blemasle/gpstracker-pcb/gpstracker-interface.sch

## KiCad design gpstracker-interface.sch (2019-01-05)

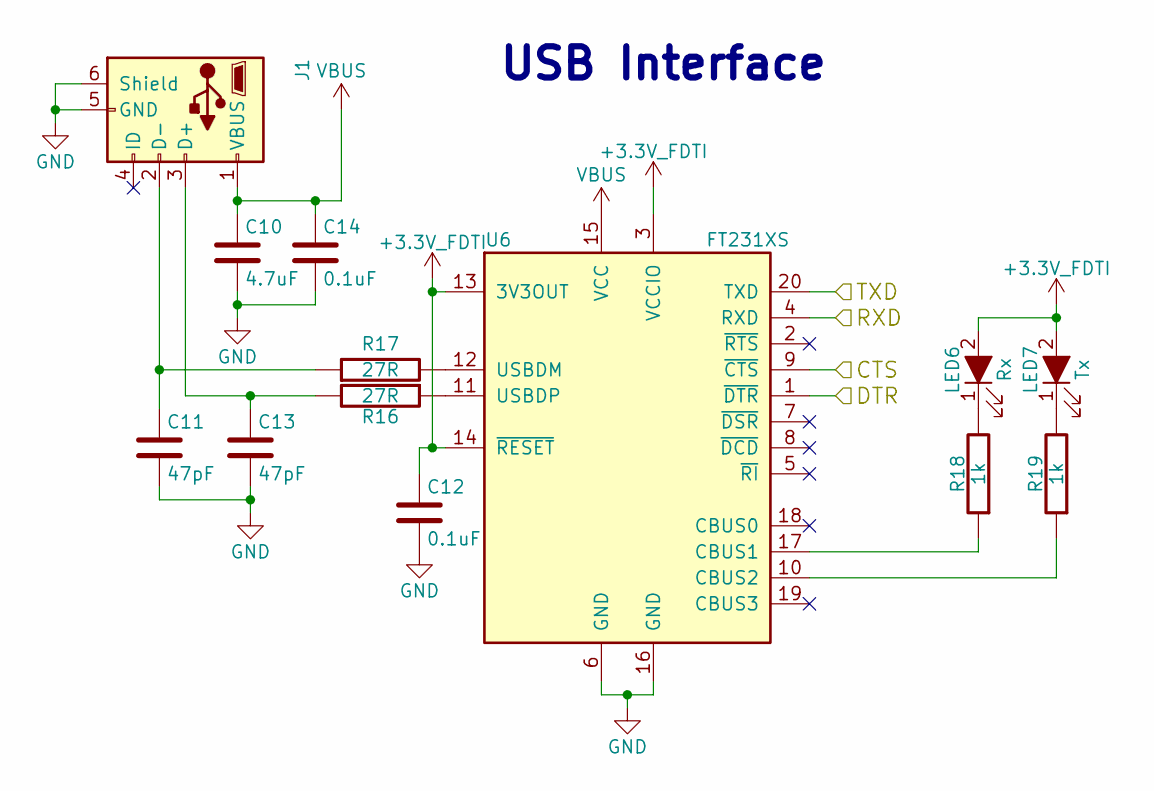
[picture p1: schematic gpstracker-interface.sch]

Parts:
C10: 4.7uF; C_0805_HandSoldering; Manufacturer part number C0805C104M3RACTU
C11, C13: 47pF; C_0805_HandSoldering; Manufacturer part number VJ0805A470GXJPW1BC
C12, C14: 0.1uF; C_0805_HandSoldering; Manufacturer part number C0805C104M3RACTU
J1: Molex 105133-0002; USB_Micro-B_Wuerth-614105150721_Vertical_CircularHoles; Manufacturer part number 614105150721
LED6: Rx; LED_0805_HandSoldering; Manufacturer part number APT2012SYCK
LED7: Tx; LED_0805_HandSoldering; Manufacturer part number APT2012EC
R16, R17: 27R; R_0805_HandSoldering; Manufacturer part number ERJ-6GEYJ270V
R18, R19: 1k; R_0805_HandSoldering; Manufacturer part number ERJ-6GEYJ102V
U6: FT231XS; SSOP-20_4.4x6.5mm_Pitch0.65mm; Manufacturer part number FT231XS-U

Connections:
+3.3V_FDTI: C12.1, LED6.2 (A), LED7.2 (A), U6.3 (VCCIO), U6.13 (3V3OUT), U6.14 (~RESET)
CTS: U6.9 (~CTS)
DTR: U6.1 (~DTR)
GND: C10.2, C11.2, C12.2, C13.2, C14.2, J1.5 (GND), J1.6 (Shield), U6.6 (GND), U6.16 (GND)
unnamed: C11.1, J1.2 (D-), R17.1
unnamed: C13.1, J1.3 (D+), R16.2
unnamed: LED6.1 (K), R18.2
unnamed: LED7.1 (K), R19.2
unnamed: R16.1, U6.11 (USBDP)
unnamed: R17.2, U6.12 (USBDM)
unnamed: R18.1, U6.17 (CBUS1)
unnamed: R19.1, U6.10 (CBUS2)
RXD: U6.4 (RXD)
TXD: U6.20 (TXD)
VBUS: C10.1, C14.1, J1.1 (VBUS), U6.15 (VCC)

Notes on the sheet:
USB Interface
