blemasle/gpstracker-pcb/gpstracker.sch

## KiCad design gpstracker.sch (2019-01-05)

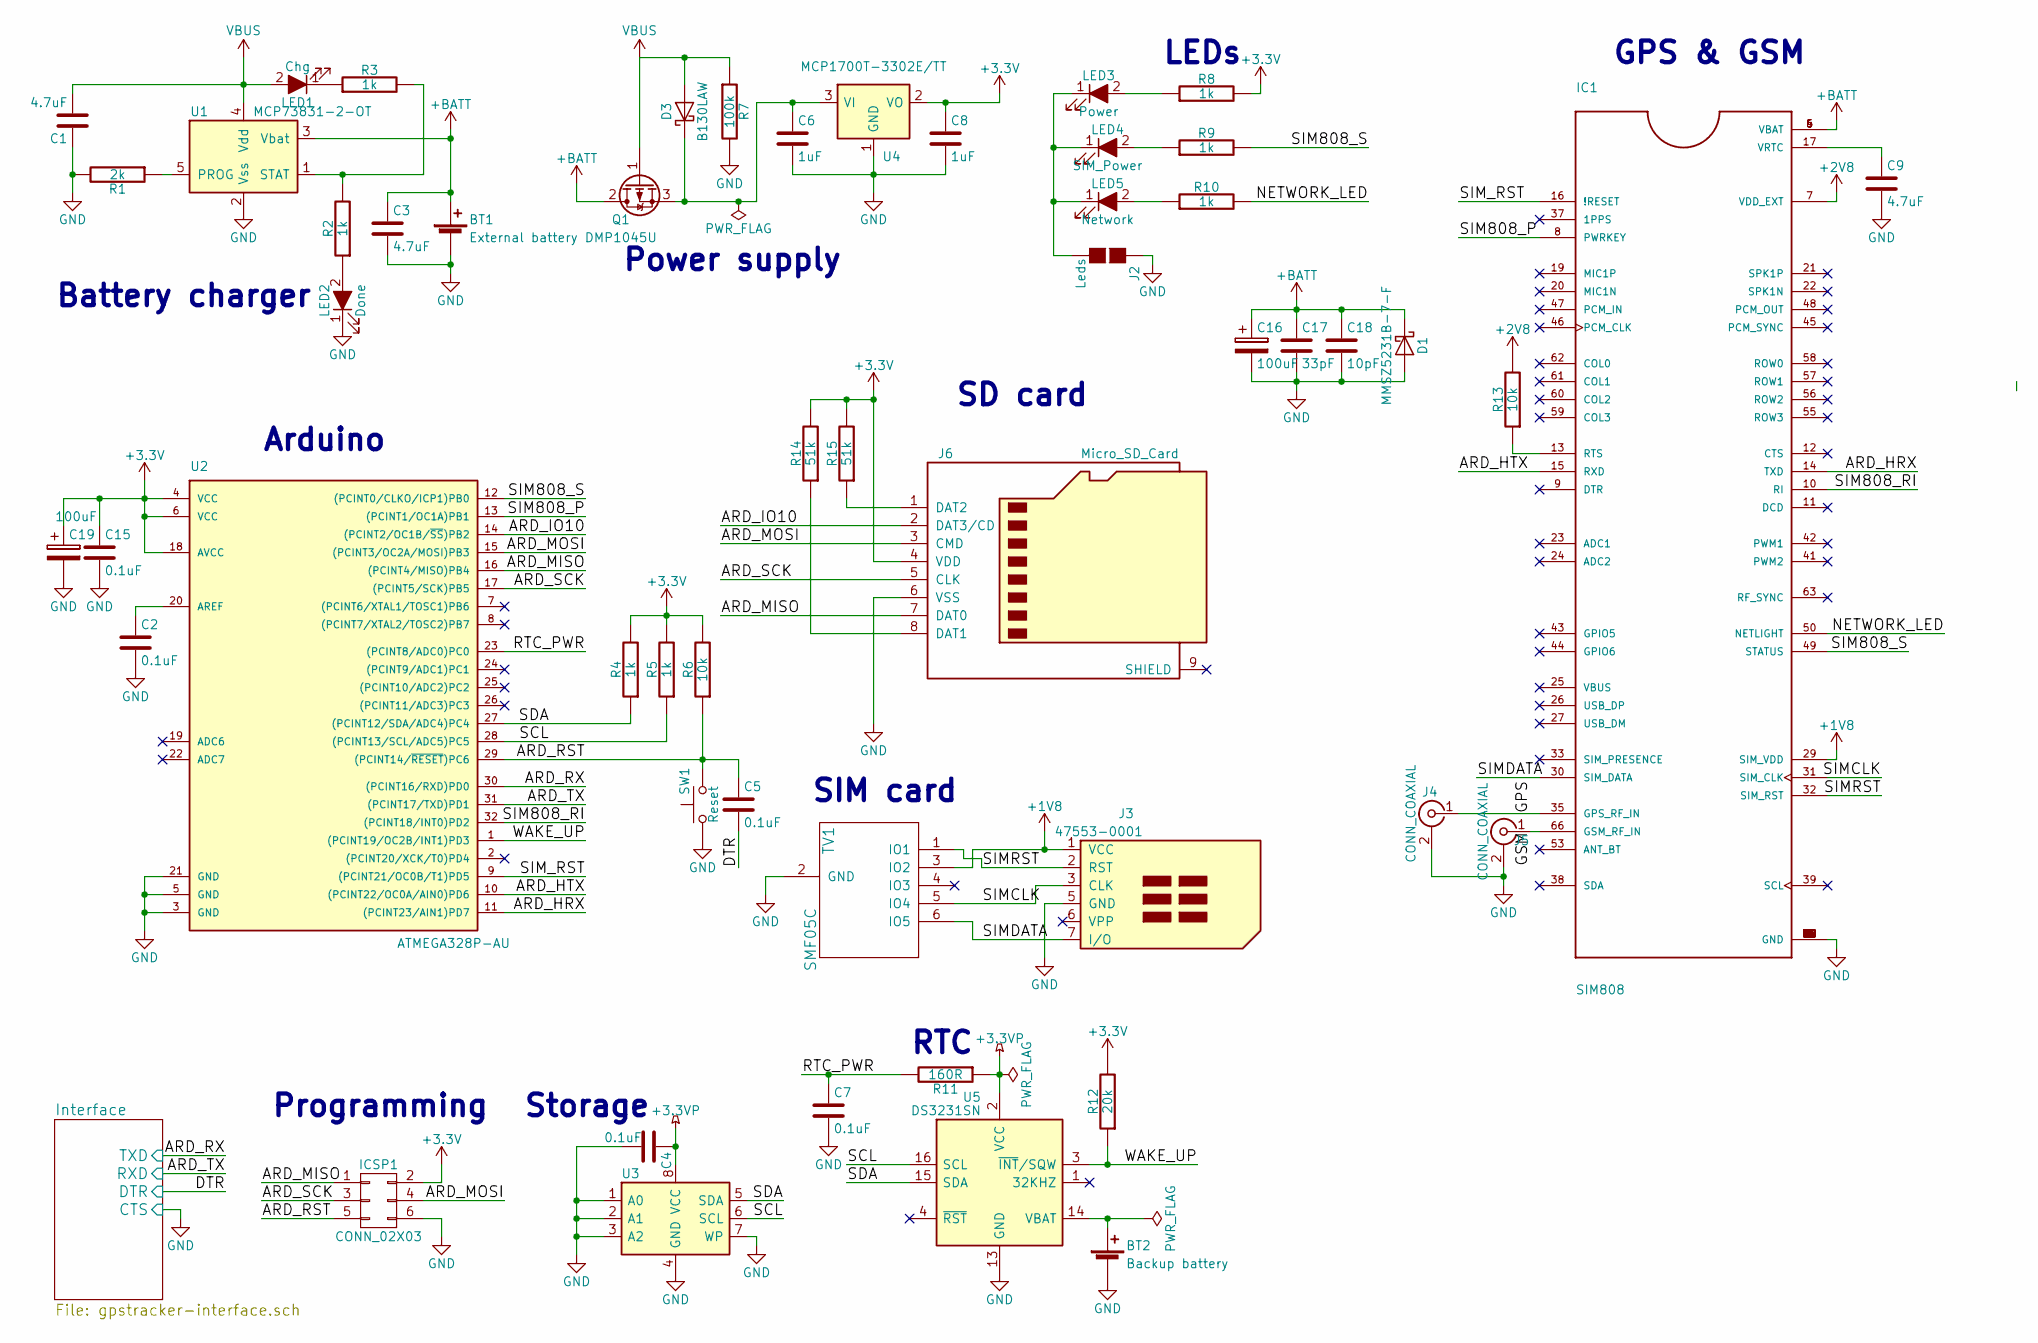
[picture p2: schematic gpstracker.sch]

Parts:
BT1: External battery; JST_PH_S2B-PH-SM4-TB_02x2.00mm_Angled; Manufacturer part number S2B-PH-SM4-TB
BT2: Backup battery; Keystone_1058_1x2032-CoinCell; Manufacturer part number 1058
C1, C3, C9: 4.7uF; C_0805_HandSoldering; Manufacturer part number C0805X475J4RACAUTO
C2, C4, C5, C7, C15: 0.1uF; C_0805_HandSoldering; Manufacturer part number C0805C104M3RACTU
C6, C8: 1uF; C_0805_HandSoldering; Manufacturer part number C0805C105K4RACTU
C16, C19: 100uF; CP_Elec_6.3x7.7; Manufacturer part number EEE-TPC101XAP
C17: 33pF; C_0805_HandSoldering; Manufacturer part number VJ0805A330GXJCW1BC
C18: 10pF; C_0805_HandSoldering; Manufacturer part number VJ0805A100GXJCW1BC
D1: MMSZ5231B-7-F; D_SOD-123; Manufacturer part number MMSZ5231B-7-F
D3: B130LAW; D_SOD-123; Manufacturer part number B130LAW-7-F
IC1: SIM808; QFN100P2400X2400X260-68N; Manufacturer part number SIM808
ICSP1: CONN_02X03; VASCH3x2; Manufacturer part number 75869-131LF
J2: Leds; Pin_Header_Straight_1x02_Pitch2.54mm
J3: 47553-0001; Manufacturer part number 47553-0001
J4, J5: CONN_COAXIAL; Molex_Microcoaxial_RF; Manufacturer part number CONUFL001-SMD
J6: Micro_SD_Card; Hirose_DM3AT-SF-PEJM5; Manufacturer part number DM3AT-SF-PEJM5
LED1: Chg; LED_0805_HandSoldering; Manufacturer part number APT2012SECK
LED2: Done; LED_0805_HandSoldering; Manufacturer part number APT2012SGC
LED3: Power; LED_0805_HandSoldering; Manufacturer part number APT2012SGC
LED4: SIM_Power; LED_0805_HandSoldering; Manufacturer part number APT2012SECK
LED5: Network; LED_0805_HandSoldering; Manufacturer part number APT2012EC
Q1: DMP1045U; SOT-23_Handsoldering; Manufacturer part number DMP1045U-7
R1: 2k; R_0805_HandSoldering; Manufacturer part number ERJ-6GEYJ202V
R2, R3, R4, R5, R8, R9, R10: 1k; R_0805_HandSoldering; Manufacturer part number ERJ-6GEYJ102V
R6, R13: 10k; R_0805_HandSoldering; Manufacturer part number ERJ-6GEYJ103V
R7: 100k; R_0805_HandSoldering; Manufacturer part number ERJ-6GEYJ104V
R11: 160R; R_0805_HandSoldering; Manufacturer part number ERJ-6GEYJ161V
R12: 20k; R_0805_HandSoldering; Manufacturer part number ERJ-6GEYJ203V
R14, R15: 51k; R_0805_HandSoldering; Manufacturer part number ERJ-6ENF5102V
SW1: Reset; SW_SPST_B3S-1000; Manufacturer part number B3S-1000
TV1: SMF05C; SOT-363_SC-70-6_Handsoldering; Manufacturer part number SMF05C
U1: MCP73831-2-OT; SOT-23-5_HandSoldering; Manufacturer part number MCP73831T-2ACI/OT
U2: ATMEGA328P-AU; TQFP-32_7x7mm_Pitch0.8mm; Manufacturer part number ATMEGA328P-AU
U3: 24LC512; SOIC-8_3.9x4.9mm_Pitch1.27mm; Manufacturer part number 24LC512T-I/SN
U4: MCP1700T-3302E/TT; SOT-23_Handsoldering; Manufacturer part number MCP1700T-3302E/TT
U5: DS3231SN; SOIC-16W_7.5x10.3mm_Pitch1.27mm; Manufacturer part number DS3231SN#

Connections:
+1V8: IC1.29 (SIM_VDD), J3.1 (VCC), TV1.3 (IO2)
+2V8: IC1.7 (VDD_EXT), R13.2
+3.3V: C8.1, C15.1, C19.1, ICSP1.2, J6.4 (VDD), R4.2, R5.2, R6.2, R8.2, R12.2, R14.2, R15.2, U2.4 (VCC), U2.6 (VCC), U2.18 (AVCC), U4.2 (VO)
+3.3VP: C4.1, R11.1, U3.8 (VCC), U5.2 (VCC)
+BATT: BT1.1 (+), C3.1, C16.1, C17.1, C18.1, D1.1 (K), IC1.4 (VBAT), IC1.5 (VBAT), IC1.6 (VBAT), Q1.2 (D), U1.3 (Vbat)
ARD_HRX: IC1.14 (TXD), U2.11 ((PCINT23/AIN1)PD7)
ARD_HTX: IC1.15 (RXD), U2.10 ((PCINT22/OC0A/AIN0)PD6)
ARD_IO10: J6.2 (DAT3/CD), U2.14 ((PCINT2/OC1B/~SS~)PB2)
ARD_MISO: ICSP1.1, J6.7 (DAT0), U2.16 ((PCINT4/MISO)PB4)
ARD_MOSI: ICSP1.4, J6.3 (CMD), U2.15 ((PCINT3/OC2A/MOSI)PB3)
ARD_RST: C5.1, ICSP1.5, R6.1, SW1.2, U2.29 ((PCINT14/~RESET~)PC6)
ARD_RX: U2.30 ((PCINT16/RXD)PD0)
ARD_SCK: ICSP1.3, J6.5 (CLK), U2.17 ((PCINT5/SCK)PB5)
ARD_TX: U2.31 ((PCINT17/TXD)PD1)
DTR: C5.2
GND: BT1.2 (-), BT2.2 (-), C1.1, C2.2, C3.2, C4.2, C6.2, C7.2, C8.2, C9.2, C15.2, C16.2, C17.2, C18.2, C19.2, D1.2 (A), IC1.1 (GND), IC1.2 (GND), IC1.3 (GND), IC1.18 (GND), IC1.28 (GND), IC1.34 (GND), IC1.36 (GND), IC1.40 (GND), IC1.51 (GND), IC1.52 (GND), IC1.54 (GND), IC1.64 (GND), IC1.65 (GND), IC1.67 (GND), IC1.68 (GND), ICSP1.6, J2.1 (G1), J3.5 (GND), J4.2 (Ext), J5.2 (Ext), J6.6 (VSS), LED2.1 (K), R1.2, R7.2, SW1.1, TV1.2 (GND), U1.2 (Vss), U2.3 (GND), U2.5 (GND), U2.21 (GND), U3.1 (A0), U3.2 (A1), U3.3 (A2), U3.4 (GND), U3.7 (WP), U4.1 (GND), U5.5 (NC), U5.6 (NC), U5.7 (NC), U5.8 (NC), U5.9 (NC), U5.10 (NC), U5.11 (NC), U5.12 (NC), U5.13 (GND)
GPS: IC1.35 (GPS_RF_IN), J4.1 (In)
GSM: IC1.66 (GSM_RF_IN), J5.1 (In)
NETWORK_LED: IC1.50 (NETLIGHT), R10.2
unnamed: BT2.1 (+), U5.14 (VBAT)
unnamed: C2.1, U2.20 (AREF)
unnamed: C6.1, D3.1 (K), Q1.3 (S), U4.3 (VI)
unnamed: C9.1, IC1.17 (VRTC)
unnamed: IC1.13 (RTS), R13.1
unnamed: J2.2 (G2), LED3.1 (K), LED4.1 (K), LED5.1 (K)
unnamed: J6.1 (DAT2), R15.1
unnamed: J6.8 (DAT1), R14.1
unnamed: LED1.1 (K), R3.1
unnamed: LED2.2 (A), R2.1
unnamed: LED3.2 (A), R8.1
unnamed: LED4.2 (A), R9.1
unnamed: LED5.2 (A), R10.1
unnamed: R1.1, U1.5 (PROG)
unnamed: R2.2, R3.2, U1.1 (STAT)
RTC_PWR: C7.1, R11.2, U2.23 ((PCINT8/ADC0)PC0)
SCL: R5.1, U2.28 ((PCINT13/SCL/ADC5)PC5), U3.6 (SCL), U5.16 (SCL)
SDA: R4.1, U2.27 ((PCINT12/SDA/ADC4)PC4), U3.5 (SDA), U5.15 (SDA)
SIM808_P: IC1.8 (PWRKEY), U2.13 ((PCINT1/OC1A)PB1)
SIM808_RI: IC1.10 (RI), U2.32 ((PCINT18/INT0)PD2)
SIM808_S: IC1.49 (STATUS), R9.2, U2.12 ((PCINT0/CLKO/ICP1)PB0)
SIMCLK: IC1.31 (SIM_CLK), J3.3 (CLK), TV1.5 (IO4)
SIMDATA: IC1.30 (SIM_DATA), J3.7 (I/O), TV1.6 (IO5)
SIMRST: IC1.32 (SIM_RST), J3.2 (RST), TV1.1 (IO1)
SIM_RST: IC1.16 (!RESET), U2.9 ((PCINT21/OC0B/T1)PD5)
VBUS: C1.2, D3.2 (A), LED1.2 (A), Q1.1 (G), R7.1, U1.4 (Vdd)
WAKE_UP: R12.1, U2.1 ((PCINT19/OC2B/INT1)PD3), U5.3 (~INT~/SQW)

Notes on the sheet:
Battery charger
Power supply
Arduino
SIM card
SD card
GPS & GSM
Programming
Storage
LEDs
RTC
