blemasle/gpstracker-pcb/(commit log)

2017-08-27 Initial commit. Many additional librairies will be removed later
    [gpstracker.kicad_pcb, gpstracker.sch]
2017-12-12 Major building blocks are there
    [gpstracker.sch]
2017-12-13 Power supplies
    [gpstracker.sch]
2017-12-16 Circuitry is mostly done
    [gpstracker.sch]
2017-12-16 Replaced SIM808 lib with a better one
    [gpstracker.sch]
2017-12-16 Started footprints assignment
    [gpstracker.sch]
2017-12-17 Done schematic (not verified)
    [gpstracker-interface.sch, gpstracker.kicad_pcb, gpstracker.sch]
2017-12-17 Component placement
    [gpstracker-interface.sch, gpstracker.kicad_pcb, gpstracker.sch]
2017-12-17 Started routing
    [gpstracker-interface.sch, gpstracker.kicad_pcb, gpstracker.sch]
2017-12-18 More routing
    [gpstracker-interface.sch, gpstracker.kicad_pcb, gpstracker.sch]
2017-12-18 Started redo - FTDI / USB
    [gpstracker.kicad_pcb]
2017-12-18 Redo - Arduino, Sim & power supply
    [gpstracker.kicad_pcb, gpstracker.sch]
2017-12-23 All major components are roughly placed
    [_saved_gpstracker.sch, gpstracker.kicad_pcb]
2017-12-24 Most of the routing is done (missing sdcard)
    [_saved_gpstracker.sch, gpstracker-interface.sch, gpstracker.kicad_pcb, gpstracker.sch]
2017-12-24 Finsihed routing
    [gpstracker.kicad_pcb]
2018-01-03 Finished PCB, powering eeprom from arduino
    [gpstracker-interface.sch, gpstracker.kicad_pcb, gpstracker.sch]
2018-01-03 Added via near decoupling capacitors
    [gpstracker.kicad_pcb]
2018-01-03 Added vias to the whole PCB
    [gpstracker.kicad_pcb]
2018-01-03 Antennas tracks impedance to 50ohm (1.5mm thick)
    [gpstracker.kicad_pcb]
2018-01-03 Submitted version for verification
    [gpstracker.kicad_pcb]
2018-01-04 Change a few tracks/via to avoid ground planes breaks
    [gpstracker.kicad_pcb]
2018-01-05 Specified conda and resistors. PCB needs to be updated (usb condo from 1210 to 0805)
    [gpstracker-interface.sch, gpstracker.sch]
2018-01-07 Made the usb connector vertical
    [gpstracker-interface.sch, gpstracker.kicad_pcb, gpstracker.sch]
2018-01-08 Ordered PCB
    [gpstracker-interface.sch, gpstracker.csv, gpstracker.kicad_pcb, gpstracker.sch]
2018-01-08 Fixed references for 4.7uF capacitor
    [gpstracker-interface.sch, gpstracker.sch]
2018-01-08 Replaced USB connector by Wuerth one
    [gpstracker-interface.sch]
2018-01-08 Changed PCB with the Wuerth USB connector
    [gpstracker.kicad_pcb]
2018-01-08 Rounded corners
    [gpstracker.kicad_pcb]
2018-01-08 Moved BT2 up
    [gpstracker.kicad_pcb]
2018-01-08 Update BOM and added some vias
    [gpstracker-interface.sch, gpstracker.csv, gpstracker.kicad_pcb]
2018-01-08 Updated schematics references with updated and available parts. This is the version that was ordered on Mouser/Seeedstudio
    [gpstracker-interface.sch, gpstracker.csv, gpstracker.kicad_pcb, gpstracker.sch]
2018-01-16 Disconnected SD card detect from ground. Made usb GND pad bigger
    [gpstracker.kicad_pcb]
2018-01-17 Flip back sd card footprint. Routing around pull up resistor is to be redone
    [gpstracker.kicad_pcb]
2018-01-17 Augmented the pad size of the battery holder for hand soldering
    [gpstracker.kicad_pcb, gpstracker.sch]
2018-01-17 PCB version bump
    [gpstracker.kicad_pcb]
2018-01-17 Moved SIM808_S track a bit to leave more room for GND1 of the SIM card
    [gpstracker.kicad_pcb]
2018-01-17 Enhanced routing of the sd card pullup resistors
    [gpstracker.kicad_pcb]
2018-01-17 Moved some silkscreen references
    [gpstracker.kicad_pcb]
2018-01-18 Move sd card right pull up resistor a bit avoid conflicts
    [gpstracker.kicad_pcb]
2018-01-18 Replaced MOLEX_104031-0811 with cheaper and easier Hirose_DM3AT-SF-PEJM5
    [gpstracker.kicad_pcb, gpstracker.sch]
2018-01-21 Fix SIM808 reset pin being tied to hardware reset. Fixed ground pads on sdcard
    [gpstracker.kicad_pcb, gpstracker.sch]
2018-01-22 Made SIM808 pads longer for easier hand soldering
    [gpstracker.kicad_pcb]
2018-02-05 Fixed LED6 & LED7 being polarity reversed
    [gpstracker-interface.sch, gpstracker.kicad_pcb]
2018-02-05 Pulled down WP pin of 24LC512 to avoid floating pin issues that prevents writing to the chip (not reported on pcb yet).
    [gpstracker.sch]
2018-02-07 Changed MCP73831T-2ACI/OT to MCP73832T-5ACI/OT
    [gpstracker.sch]
2018-02-07 Reported last changes from schematics to PCB
    [gpstracker.kicad_pcb, gpstracker.sch]
